andrewhaggstrom0/tsp05-sensors-motor-control/calibration/plots/dc_position_steps_compare.png

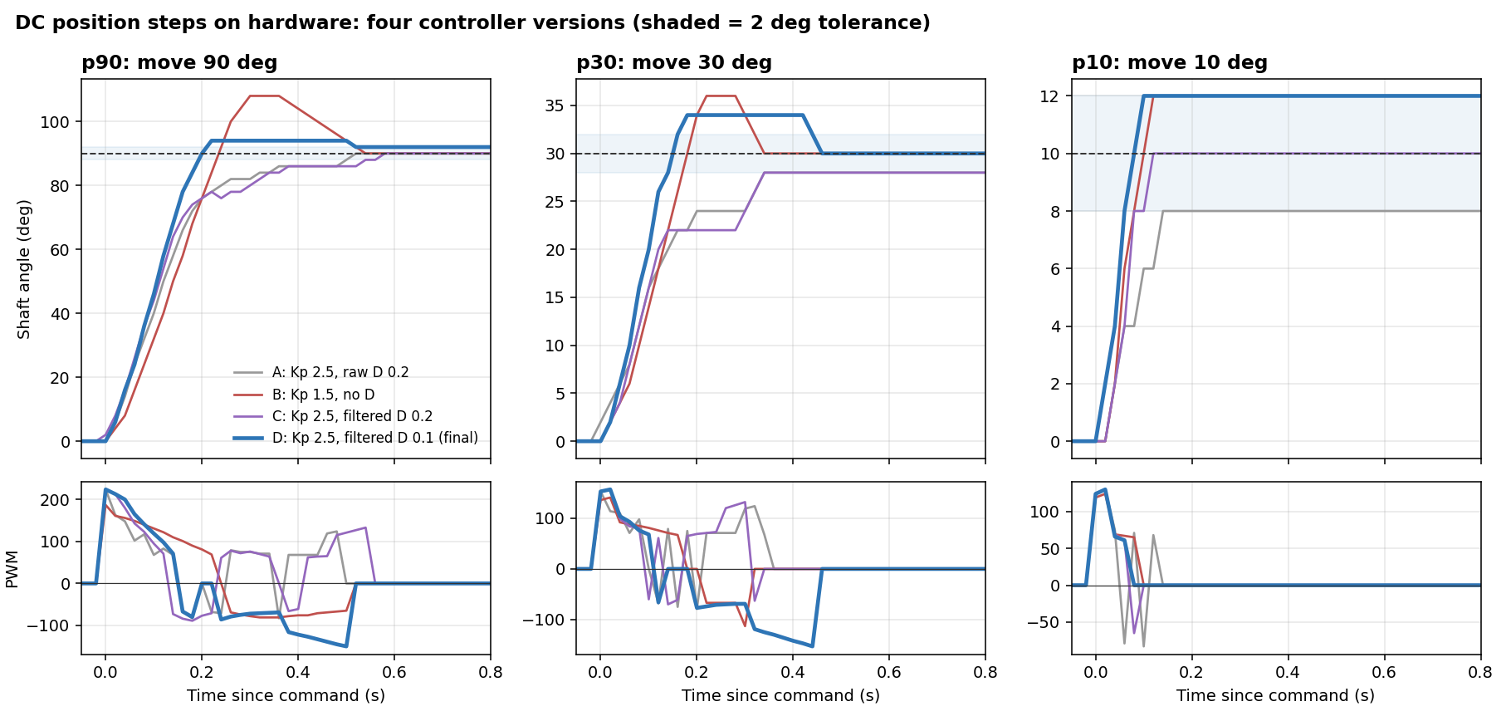
calibration/plots/dc_position_steps_compare.png
