andrewhaggstrom0/tsp05-sensors-motor-control/calibration/plots/dc_step_v60.png

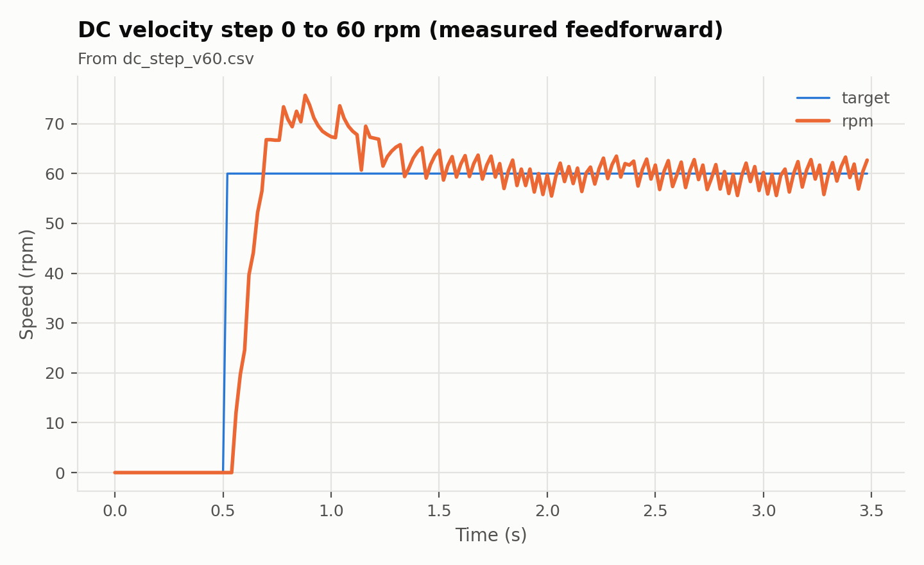
calibration/plots/dc_step_v60.png
