andrewhaggstrom0/tsp05-sensors-motor-control/calibration/plots/dc_step_v60_compare.png

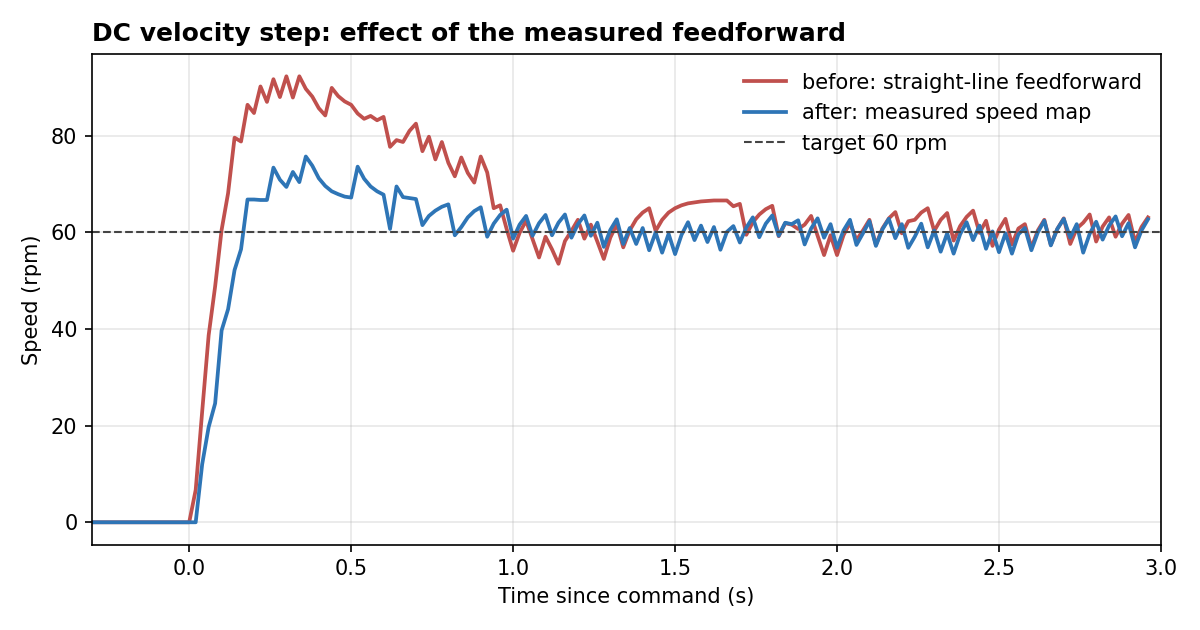
calibration/plots/dc_step_v60_compare.png
