andrewhaggstrom0/tsp05-sensors-motor-control/calibration/plots/dc_step_v60_linear_ff.png

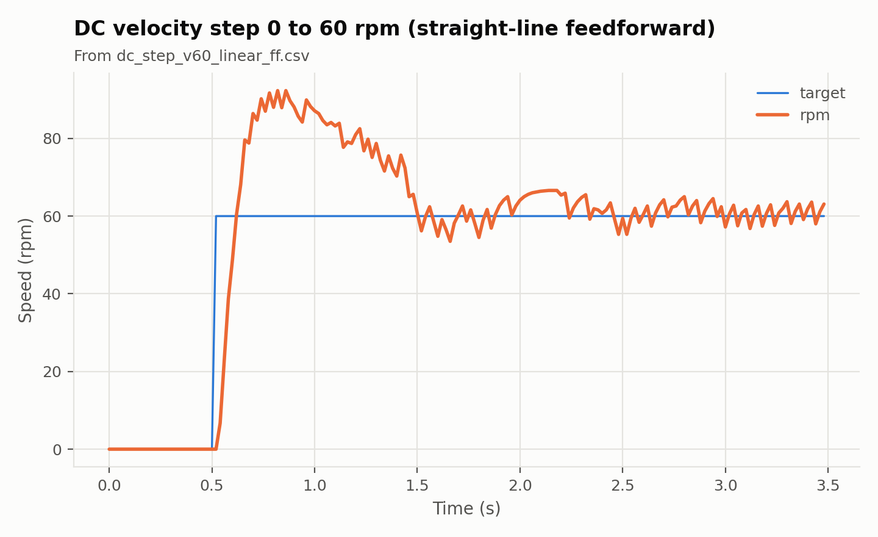
calibration/plots/dc_step_v60_linear_ff.png
