andrewhaggstrom0/tsp05-sensors-motor-control/calibration/data/dc_counts_per_rev.csv

direction | trial | turns | counts
forward | 1 | 10 | 1799
