andrewhaggstrom0/tsp05-sensors-motor-control/calibration/data/dc_speed_map.csv

direction | pwm | counts_per_s_mean | counts_per_s_std | n
forward | 255 | 422.0 | 2.4 | 5
forward | 230 | 379.0 | 2.0 | 5
forward | 205 | 360.0 | 2.9 | 6
forward | 180 | 341.0 | 2.0 | 5
forward | 155 | 312.5 | 2.5 | 6
forward | 130 | 280.0 | 2.9 | 6
forward | 110 | 237.5 | 2.5 | 6
forward | 95 | 194.2 | 1.9 | 6
forward | 85 | 161.0 | 2.0 | 5
forward | 75 | 123.0 | 2.4 | 5
forward | 68 | 94.0 | 2.0 | 5
forward | 63 | 71.7 | 2.4 | 6
reverse | -255 | -445.8 | 1.9 | 6
reverse | -230 | -385.0 | 0.0 | 6
reverse | -205 | -361.7 | 2.4 | 6
reverse | -180 | -339.2 | 1.9 | 6
reverse | -155 | -304.2 | 1.9 | 6
reverse | -130 | -256.7 | 3.7 | 6
reverse | -110 | -211.7 | 2.4 | 6
reverse | -95 | -167.5 | 2.5 | 6
reverse | -85 | -136.0 | 2.0 | 5
reverse | -75 | -99.0 | 2.0 | 5
reverse | -68 | -73.0 | 2.4 | 5
reverse | -63 | -55.8 | 1.9 | 6
