andrewhaggstrom0/tsp05-sensors-motor-control/calibration/data/flex.csv

trial | direction | ref_deg | adc_mean | adc_std | n
1 | bend | 0.0 | 470.20 | 0.53 | 50
1 | bend | 15.0 | 445.26 | 8.50 | 50
1 | bend | 30.0 | 399.72 | 9.19 | 50
1 | bend | 45.0 | 380.68 | 8.36 | 50
1 | bend | 60.0 | 371.14 | 10.34 | 50
1 | bend | 75.0 | 338.02 | 7.89 | 50
1 | bend | 90.0 | 306.84 | 9.40 | 50
