andrewhaggstrom0/tsp05-sensors-motor-control/calibration/data/flex_filter.csv

t_s | flex_adc
0.000 | 463
0.020 | 463
0.040 | 464
0.060 | 464
0.080 | 464
0.100 | 464
0.120 | 464
0.140 | 463
0.160 | 464
0.180 | 463
0.200 | 463
0.220 | 464
0.240 | 464
0.260 | 464
0.280 | 464
0.300 | 463
0.320 | 465
0.340 | 462
0.360 | 464
0.380 | 463
0.400 | 463
0.420 | 463
0.440 | 463
0.460 | 463
0.480 | 463
0.500 | 463
0.520 | 463
0.540 | 462
0.560 | 463
0.580 | 462
0.600 | 463
0.620 | 462
0.640 | 462
0.660 | 463
0.680 | 463
0.700 | 463
0.720 | 463
0.740 | 463
0.760 | 463
0.780 | 464
0.800 | 463
0.820 | 464
0.840 | 463
0.860 | 464
0.880 | 464
0.900 | 464
0.920 | 464
0.940 | 464
0.960 | 463
0.980 | 464
1.000 | 463
1.020 | 463
1.040 | 462
1.060 | 463
1.080 | 463
1.100 | 462
1.120 | 461
1.140 | 459
1.160 | 461
1.180 | 462
1.200 | 458
1.220 | 460
1.240 | 459
1.260 | 460
1.280 | 461
1.300 | 459
1.320 | 461
1.340 | 454
1.360 | 453
1.380 | 453
1.400 | 443
1.420 | 435
1.440 | 434
1.460 | 436
1.480 | 435
1.500 | 419
1.520 | 409
1.540 | 405
1.560 | 418
1.580 | 414
1.600 | 413
1.620 | 392
1.640 | 400
1.660 | 377
1.680 | 394
1.700 | 384
1.720 | 378
1.740 | 367
1.760 | 365
1.780 | 368
1.800 | 362
1.820 | 341
1.840 | 351
1.860 | 346
1.880 | 357
1.900 | 342
1.920 | 342
1.940 | 335
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
