andrewhaggstrom0/tsp05-sensors-motor-control/calibration/data/slot_rpm.csv

t_s | step_deg | slot_count | slot_rpm
0.000 | 0.000 | 0 | 0.00
0.050 | 6.080 | 0 | 0.00
0.100 | 14.180 | 0 | 0.00
0.150 | 22.050 | 1 | 0.00
0.201 | 29.700 | 1 | 0.00
0.251 | 37.580 | 1 | 0.00
0.301 | 45.230 | 1 | 0.00
0.351 | 52.880 | 1 | 0.00
0.402 | 60.300 | 1 | 0.00
0.452 | 67.950 | 1 | 0.00
0.502 | 75.380 | 1 | 0.00
0.552 | 83.250 | 1 | 0.00
0.602 | 90.900 | 1 | 0.00
0.652 | 98.550 | 1 | 0.00
0.702 | 106.200 | 1 | 0.00
0.752 | 113.850 | 1 | 0.00
0.802 | 121.500 | 1 | 0.00
0.852 | 129.150 | 1 | 0.00
0.903 | 137.020 | 1 | 0.00
0.953 | 144.900 | 1 | 0.00
1.003 | 152.550 | 1 | 0.00
1.053 | 160.200 | 1 | 0.00
1.103 | 167.850 | 1 | 0.00
1.153 | 175.500 | 1 | 0.00
1.203 | 182.930 | 1 | 0.00
1.253 | 190.580 | 1 | 0.00
1.303 | 198.680 | 1 | 0.00
1.353 | 206.330 | 1 | 0.00
1.403 | 214.200 | 1 | 0.00
1.453 | 221.850 | 1 | 0.00
1.503 | 229.500 | 1 | 0.00
1.554 | 237.380 | 1 | 0.00
1.603 | 245.030 | 1 | 0.00
1.653 | 252.680 | 1 | 0.00
1.703 | 260.330 | 1 | 0.00
1.754 | 268.200 | 1 | 0.00
1.803 | 275.630 | 1 | 0.00
1.853 | 283.280 | 1 | 0.00
1.903 | 290.920 | 1 | 0.00
1.954 | 298.800 | 1 | 0.00
2.003 | 306.450 | 1 | 0.00
2.054 | 314.330 | 1 | 0.00
2.104 | 322.200 | 1 | 0.00
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
