andrewhaggstrom0/tsp05-sensors-motor-control/firmware/tsp05/dc_motor.h

#pragma once

void  dcInit();
void  dcUpdate();                  // call every loop(); runs the controller every DC_PERIOD_MS

void  dcMoveRelative(float deg);   // position mode: move deg from current position
void  dcSetVelocity(float rpm);    // velocity mode: hold signed rpm
void  dcStop();
void  dcSetInterlock(bool active); // true: stop and ignore commands

float dcDeg();
float dcRpm();
int   dcPwm();                     // -255..255
bool  dcArrived();                 // position mode: within DC_POS_TOL_DEG of target
int   dcMode();                    // 0 idle, 1 velocity, 2 position (telemetry dc_mode)
float dcTarget();                  // position mode: target deg; velocity mode: target rpm; idle: 0
