andrewhaggstrom0/tsp05-sensors-motor-control/firmware/tests/test_sensors_analog.cpp

// Host-side tests for firmware/tsp05/sensors_analog.cpp
// Run: firmware/tests/run_tests.sh
#include <cstdio>
#include <cmath>
#include "Arduino.h"
#include "config.h"
#include "sensors_analog.h"

int fake_adc[24] = {0};
uint32_t fake_millis = 0;
long fake_analog_reads = 0;

static int g_fail = 0, g_pass = 0;
#define CHECK(cond, ...) do { if (cond) { g_pass++; } else { g_fail++; \
  printf("FAIL %s:%d  ", __FILE__, __LINE__); printf(__VA_ARGS__); printf("\n"); } } while (0)

using namespace analog_math;

// Independent reference (double precision) to check the firmware math
static double refThermC(double adc) {
  // Uses the config.h constants, so it stays valid after measured resistor
  // values or a datasheet B are put in config.h.
  double r = (double)THERM_FIXED_R_OHMS * adc / (1023.0 - adc);
  return 1.0 / (1.0 / (double)THERM_T0_K + std::log(r / (double)THERM_R0_OHMS) / (double)THERM_BETA)
         - 273.15;
}

static void test_thermistor_math() {
  // When R_t = R0 the temperature is exactly T0 (25 degC). That happens at
  // adc = 1023 * R0 / (R_fixed + R0), which is 511.5 only if R_fixed = R0.
  float adcAtT0 = 1023.0f * THERM_R0_OHMS / (THERM_FIXED_R_OHMS + THERM_R0_OHMS);
  float c = thermCFromOhms(thermOhmsFromAdc(adcAtT0));
  float t0c = THERM_T0_K - 273.15f;
  CHECK(std::fabs(c - t0c) < 0.01f, "R_t = R0 gave %.3f C, want %.2f", c, t0c);

  // Matches double-precision reference across the usable range
  for (int adc = 50; adc <= 970; adc += 20) {
    float got = thermCFromOhms(thermOhmsFromAdc((float)adc));
    double want = refThermC(adc);
    CHECK(std::fabs(got - want) < 0.05, "adc %d: got %.3f want %.3f", adc, got, want);
  }

  // Warmer -> lower thermistor R -> lower A1 counts: temperature must fall as adc rises
  float prev = 1e9f;
  for (int adc = THERM_ADC_SHORT + 1; adc < THERM_ADC_OPEN; adc++) {
    float t = thermCFromOhms(thermOhmsFromAdc((float)adc));
    CHECK(std::isfinite(t), "adc %d gave non-finite temp", adc);
    CHECK(t < prev, "not monotonic at adc %d", adc);
    prev = t;
  }

  // Round trip at real operating points (ice bath, body): degC -> ohms (Beta
  // law) -> counts (divider) -> back through the firmware. Uses config.h, so it
  // holds for measured resistor values too.
  const float pts[] = {0.0f, 37.0f, 55.0f};
  for (float tc : pts) {
    double rt = THERM_R0_OHMS * std::exp(THERM_BETA * (1.0 / (tc + 273.15) - 1.0 / THERM_T0_K));
    float adc = (float)(1023.0 * rt / (THERM_FIXED_R_OHMS + rt));
    float back = thermCFromOhms(thermOhmsFromAdc(adc));
    CHECK(std::fabs(back - tc) < 0.05f, "%.0f C -> %.1f counts -> %.3f C", tc, adc, back);
  }

  // Edge cases
  CHECK(thermOhmsFromAdc(0) < 0 && thermOhmsFromAdc(1023) < 0, "edge adc should be -1");
  CHECK(std::isnan(thermCFromOhms(-1.0f)), "negative ohms should give NaN");
  CHECK(thermAdcIsFault(1023) && thermAdcIsFault(0), "open/short must be faults");
  CHECK(!thermAdcIsFault(511), "midpoint must not be a fault");
}

static double refFlexOhms(double adc) {
  return (double)FLEX_FIXED_R_OHMS * (1023.0 - adc) / adc;
}

static void test_flex_math() {
  // Divider math against a double-precision reference
  for (int adc = 50; adc <= 970; adc += 20) {
    double want = refFlexOhms(adc);
    float got = flexOhmsFromAdc((float)adc);
    CHECK(std::fabs(got - want) / want < 1e-5, "adc %d: %.1f ohm want %.1f", adc, got, want);
  }
  CHECK(flexOhmsFromAdc(0) < 0 && flexOhmsFromAdc(1023) < 0, "edge adc should be -1");

  // Whatever table is loaded (placeholder or fitted): bending raises resistance,
  // which lowers the A0 reading, so the angle must never decrease as adc falls,
  // never be NaN, and stay inside the clamps.
  float prev = -1e9f;
  for (int adc = ADC_MAX - 1; adc >= 1; adc--) {
    float d = flexDegFromAdc((float)adc);
    CHECK(std::isfinite(d), "adc %d gave non-finite angle", adc);
    CHECK(d >= FLEX_DEG_MIN && d <= FLEX_DEG_MAX, "adc %d gave %.1f deg out of range", adc, d);
    CHECK(d >= prev, "angle not monotonic at adc %d", adc);
    prev = d;
  }
  CHECK(flexDegFromOhms(1e9f) == FLEX_DEG_MAX, "huge R should clamp to max");
  CHECK(flexDegFromOhms(0.0f) == FLEX_DEG_MIN, "zero R should clamp to min");

  // Faults: unplugged sensor pulls A0 to 0, a short pulls it to 1023
  CHECK(flexAdcIsFault(0) && flexAdcIsFault(1023), "open/short must be faults");
  CHECK(!flexAdcIsFault(506), "flat reading must not be a fault");
}

static void test_ema() {
  float y = 0.0f;
  for (int i = 0; i < 100; i++) y = ema(y, 10.0f, 0.2f);
  CHECK(std::fabs(y - 10.0f) < 1e-3f, "EMA should converge to step, got %.4f", y);
  CHECK(std::fabs(ema(0.0f, 10.0f, 0.2f) - 2.0f) < 1e-6f, "one EMA step should be 2.0");
}

static void test_module_update() {
  fake_millis = 1000;
  // Flat-ish (10k) and bent (20k) readings. Expected angles come from the
  // conversion function, so this test does not depend on which table is loaded.
  int adcFlat = (int)lround(1023.0 * FLEX_FIXED_R_OHMS / (FLEX_FIXED_R_OHMS + 10000.0));
  fake_adc[A0] = adcFlat;
  fake_adc[A1] = 512;    // ~25 C with nominal parts
  analogSensorsInit();
  CHECK(!thermistorFault(), "good reading should clear fault");
  CHECK(std::fabs(thermistorC() - (float)refThermC(512)) < 0.05f, "init temp %.2f, want %.2f",
        thermistorC(), refThermC(512));
  CHECK(!flexFault(), "flat flex reading should clear fault");
  float degFlat = flexDegFromAdc((float)adcFlat);
  CHECK(flexDeg() == degFlat && flexDegFiltered() == degFlat,
        "first reading should seed the filter: %.2f / %.2f, want %.2f",
        flexDeg(), flexDegFiltered(), degFlat);

  // Rate limiting: nothing happens before the period elapses
  int adcBent = (int)lround(1023.0 * FLEX_FIXED_R_OHMS / (FLEX_FIXED_R_OHMS + 20000.0));
  fake_adc[A0] = adcBent;
  long reads = fake_analog_reads;
  fake_millis += ANALOG_PERIOD_MS - 1;
  analogSensorsUpdate();
  CHECK(fake_analog_reads == reads, "update ran early (no ADC reads expected)");
  CHECK(flexRaw() == adcFlat, "raw changed before period elapsed");

  // After the period it samples, and the filter lags the raw value
  fake_millis += 1;
  analogSensorsUpdate();
  CHECK(flexRaw() == adcBent, "raw should update, got %d", flexRaw());
  float degBent = flexDegFromAdc((float)adcBent);
  CHECK(degBent > degFlat + 10.0f, "20k (%.1f deg) should read well above 10k (%.1f deg)",
        degBent, degFlat);
  CHECK(flexDeg() == degBent, "module should report %.2f deg, got %.2f", degBent, flexDeg());
  CHECK(flexDegFiltered() > degFlat && flexDegFiltered() < flexDeg(),
        "filtered (%.2f) should lag raw (%.2f)", flexDegFiltered(), flexDeg());

  // Unplugged flex sensor: fault set, angle holds its last good value
  float flexGood = flexDeg(), flexFiltGood = flexDegFiltered();
  fake_adc[A0] = 0;
  fake_millis += ANALOG_PERIOD_MS;
  analogSensorsUpdate();
  CHECK(flexFault(), "unplugged flex should fault");
  CHECK(flexDeg() == flexGood && flexDegFiltered() == flexFiltGood, "angle should hold during fault");
  fake_adc[A0] = adcBent;
  fake_millis += ANALOG_PERIOD_MS;
  analogSensorsUpdate();
  CHECK(!flexFault(), "flex should recover");

  // Unplugged thermistor: fault set, temperature holds last good value
  float lastGood = thermistorC();
  fake_adc[A1] = 1023;
  fake_millis += ANALOG_PERIOD_MS;
  analogSensorsUpdate();
  CHECK(thermistorFault(), "unplugged thermistor should fault");
  CHECK(thermistorC() == lastGood, "temp should hold during fault");
  CHECK(std::isfinite(thermistorC()), "temp must never be NaN");

  // Recovers when plugged back in
  fake_adc[A1] = 400;
  fake_millis += ANALOG_PERIOD_MS;
  analogSensorsUpdate();
  CHECK(!thermistorFault() && thermistorC() > 30.0f, "should recover, got %.2f", thermistorC());

  // millis() rollover does not stall updates
  fake_millis = 0xFFFFFFFFu - 5;
  analogSensorsUpdate();
  fake_adc[A0] = adcFlat;
  fake_millis = 0xFFFFFFFFu - 5 + ANALOG_PERIOD_MS;  // wraps past zero
  analogSensorsUpdate();
  CHECK(flexRaw() == adcFlat, "update should run across millis() rollover");
}

int main() {
  test_thermistor_math();
  test_flex_math();
  test_ema();
  test_module_update();
  printf("%d passed, %d failed\n", g_pass, g_fail);
  return g_fail ? 1 : 0;
}
