andrewhaggstrom0/tsp05-sensors-motor-control/(commit log)

2026-11-01 Initial repo structure: pin map, protocol spec, PR template, README skeleton
2026-11-07 Add analog sensor module: FSR force via conductance table, thermistor Beta conversion, EMA filter, fault detection
2026-11-07 Add host-side unit tests for analog module with Arduino shim
2026-11-07 Add Python reference model of analog sensors and firmware cross-check
2026-11-07 Add analog bring-up sketch and calibration logger with simulated sensor
2026-11-07 Document calibration CSV schemas and hardware-day procedure
2026-11-07 Add calibration plotter: transfer function, FSR fit and firmware table, filter plot, error tables, Foxglove CSV support
    [plot_calibration.py]
2026-11-07 Add M0 open-loop DC bring-up sketch and deadband CSV
    Serial-driven PWM (-255..255) on the L298 (D5 EN, D7/D8 IN1/IN2) to measure
    the start and stop deadband in each direction. Non-blocking line reader avoids
    Serial.parseInt(), whose leftover newline reads as a second 0 and stops the motor.
    [dc_deadband.csv]
2026-11-07 Add M1 encoder bring-up sketch and counts-per-rev CSV
    2x decoding on encoder A (INT0, CHANGE) with B read in the ISR for direction.
    The 32-bit count is copied with interrupts paused. Prints ms,pwm,counts,cps at
    5 Hz for the counts-per-rev and sign checks. Adds an empty
    calibration/data/dc_counts_per_rev.csv (direction, trial, turns, counts).
    [dc_counts_per_rev.csv]
2026-11-07 Add DC motor module: speed estimate, velocity PI, position PID, host tests
    dc_control is hardware-free: counts/deg/rpm conversions, deadband compensation,
    PID with clamped integral and no derivative kick, and a per-period controller
    step for IDLE, VELOCITY (feedforward + PI) and POSITION (PID, stop inside
    DC_POS_TOL_DEG). dc_motor wires it to the L298 and the encoder ISR and enforces
    the thermal interlock.
    Tests run the controller against a simulated motor with stick-slip friction
    and a deadband and top speed that differ from the config placeholders.
    A position Ki of 20 was needed: without it the motor stalls a few degrees
    short with a PWM below its starting deadband.
    [config.h, dc_control.cpp, dc_control.h, dc_motor.cpp, dc_motor.h, test_dc_control.cpp]
2026-11-07 Use measured divider resistors; make analog tests derive expectations from config.h
2026-11-07 Switch A0 sensor from FSR to flex sensor: report bend angle in degrees, rename API to flex*
    [analog.ino, analog_model.py, check_firmware_vs_model.py, config.h, dump_conversions.cpp, log_serial.py, plot_calibration.py, sensors_analog.cpp]
2026-11-07 Fix logger capturing stale samples over usbipd: read the port continuously in a background thread
    [log_serial.py]
2026-11-07 Add thermistor and flex calibration data, figures, error tables, and fitted flex table
    [flex.csv, flex_filter.csv, thermistor.csv]
2026-11-07 Document analog sensor wiring: schematic generated from config.h, pin map section
2026-11-08 Add DC closed-loop bring-up sketch, module sync script, step-response logger
    dc_pid.ino drives the real dc_motor module from serial commands (p<deg>,
    v<rpm>, x, i1/i0) and streams ms,mode,target,deg,rpm,pwm at 50 Hz.
    sync_dc_bringup.sh copies the module into the sketch folder (copies are
    git-ignored) so there is one source of truth in firmware/tsp05.
    log_dc_step.py sends one step command, records the stream, and writes
    calibration/data/dc_step_<cmd>.csv for plot_calibration.py --timeseries.
2026-11-08 Added servo range check code
2026-11-08 config: add Track 2 constants (servo, stepper, button, mappings, interlock)
2026-11-08 Button: 30 ms debounce, press-edge toggle
2026-11-08 Servo + non-blocking stepper
2026-11-08 Parser, modes, mappings, interlock, 20 Hz telemetry
2026-11-08 Add Docker ROS 2 dev environment and fake Arduino serial simulator
    docker/: ros:jazzy image (ROS_DISTRO=humble selectable) with
    foxglove_bridge and pyserial. The repo is mounted at /tsp05, the container
    runs as the host user, and port 8765 is published for the Foxglove app.
    docker/run.sh opens a shell or runs one command. Code stays plain ROS 2 /
    Python, so it also runs on native Ubuntu without Docker.
    tools/fake_arduino.py: a pty that speaks docs/protocol.md. It sends the
    19-field T line at 20 Hz and accepts M, S, D,P, D,V, D,X and P commands
    (motor commands ignored in SENSOR mode). Simulates the sensors (raw ADC via
    tools/analog_model.py), servo slew, a first-order DC motor with a positio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
2026-11-08 Add tsp05_bridge package with protocol parser, command formatting, and tests
    ros2_ws/src/tsp05_bridge (ament_python): tsp05_bridge/protocol.py is the
    laptop side of docs/protocol.md with no ROS dependency.
    - parse_telemetry(): 18 named fields after "T"; raises only ParseError for
    wrong field count, non-numeric or non-finite values, or a mode/interlock
    flag that is not 0/1. Accepts CRLF (Serial.println).
    - is_telemetry(): '#' comments and noise (e.g. a half line after a reset)
    are not telemetry.
    - cmd_*(): M, S, D,P, D,V, D,X, P strings with 1-decimal values; reject
    NaN/inf so a bad GUI value never reaches the Uno.
    38 pytest tests: field order is checked against docs/protocol.md itse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
    [protocol.py, test_protocol.py]
2026-11-08 Add tsp05_bridge ROS 2 node: telemetry topics, command topics, auto-reconnect
    bridge_node.py (ros2 run tsp05_bridge bridge):
    - Publishes every telemetry field on /tsp05/* (Float32; mode Int8,
    interlock Bool), names per the team guide with fsr/* -> flex/* after the
    A0 sensor change. Also /tsp05/uno_ms, /tsp05/bridge/connected (1 Hz) and
    /tsp05/log ('#' lines from the Uno, e.g. commands ignored in SENSOR mode).
    - Subscribes to /tsp05/cmd/{mode,servo_deg,dc_move_deg,dc_rpm,dc_stop,
    stepper_deg} and writes M, S, D,P, D,V, D,X, P. NaN/inf is rejected.
    - Parameters: port (device path or any pyserial URL, e.g. socket://),
    baud, reconnect_period, stats_period.
    - A background thread reads c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
    [bridge_node.py, test_bridge_integration.py]
2026-11-08 Add one-command launch file and Foxglove layout with plots and indicators
    launch/tsp05.launch.py: bridge + foxglove_bridge (0.0.0.0:8765, so the
    Foxglove app on the host reaches it through Docker's port mapping).
    ros2 launch tsp05_bridge tsp05.launch.py # real Uno
    ros2 launch tsp05_bridge tsp05.launch.py fake:=true # + fake Arduino
    Args: port, baud, fake, fake_link, foxglove, foxglove_port. The fake
    Arduino script is found by walking up from the launch file (works from the
    colcon install space) or via $TSP05_REPO. topic_whitelist limits the
    websocket to /tsp05/* and /rosout. client_topic_whitelist is not used:
    foxglove_bridge 3.6 accepted a client publisher on /tsp05/s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
2026-11-08 Add Foxglove command panel extension: mode, servo, DC, stepper, STOP
    foxglove/tsp05-control-panel: a Foxglove extension panel ("TSP05 Controls")
    so every command is sent by clicking (Track 5 step R5).
    - Mode toggle (GUI/SENSOR) showing the current mode from /tsp05/mode.
    - Servo slider + 0/90/180 presets; DC move N deg (+-90 presets) and hold
    RPM; stepper -/+ N deg; live servo, DC deg/RPM, stepper actual/target.
    - STOP works in both modes: in SENSOR mode the firmware ignores motor
    commands, so it sends M,0 then D,X.
    - Motor buttons are disabled while the Uno is disconnected (no telemetry for
    2 s or /tsp05/bridge/connected false) or in SENSOR mode; interlock banner.
    - Advertises /tsp05/c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
2026-11-08 Document Track 5 in README: running (Docker and native), contribution, challenges, figure
    README.md (Track 5 parts only):
    - Software: bridge, layout, control panel, fake Arduino, docker/; embeds the
    architecture figure.
    - Running: Docker (fake Arduino, tests, Humble, real Uno on Linux via
    TSP05_SERIAL_DEVICE, socat + socket:// on macOS), native Ubuntu (apt,
    dialout, colcon build/launch/test), Foxglove connect, layout import, panel
    install, launch arguments.
    - Individual Contributions (Raoul Bouri) with measured numbers: 19.99 Hz on
    every topic; command -> telemetry round trip median 31 ms, p95 52 ms (n=200,
    random timing); 48 + 8 tests.
    - Challenges: fake Arduino stalling on a fu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
    [draw_bridge_diagram.py, test_bridge_integration.py]
2026-11-08 Add Track 3 digital sensors interface: TOF + slot sensor API stubs
2026-11-08 Stepper verified: 1600 steps/rev; coil pairs red-green / blue-black (35.9 ohm); TP1 1.70 V
2026-11-08 Tested Servo, Stepper and Button
2026-11-08 Add TOF + slot sensor bring-up sketch: short-range TOF at 33 ms budget, slot ISR with 1 ms glitch filter
    [digital.ino]
2026-11-08 Add Track 3 constants to config.h: TOF timing, filter, slot tabs, RPM window and timeout
2026-11-08 Implement digital sensors: non-blocking TOF with median-of-5 + EMA filter, slot ISR with period-based RPM
2026-11-08 Reset TOF-present flag in init so a missing sensor is always reported
    [sensors_digital.cpp]
2026-11-08 Add host tests for digital sensors: TOF median+EMA, invalid/stale faults, slot glitch filter, period RPM with uneven tabs
    [test_sensors_digital.cpp]
2026-11-08 Add TOF calibration tool: error logging, raw-vs-filtered recording, error table and plots, --sim rehearsal
    [tof_calibration.py]
2026-11-08 README: add Track 3 contribution (TOF, slot sensor, RPM, tools, tests) and first challenge
2026-11-09 Handle stiction: separate breakaway and running deadbands, ramp while stuck
    Bench test on the SPG30: from rest it needs PWM 110-140 forward and 90-120
    reverse to start, and the amount depends on where the shaft came to rest
    (repeat starts needed 130, then 140 after 130 failed, then 115). Once turning
    it keeps going down to 56-59. With a single deadband the position loop either
    stalled short or lurched past and hunted (19 restarts on a 15 deg move in
    simulation).
    ctrlStep uses DC_DEADBAND_RUN_PWM once the motor is moving. While commanded
    but stopped, the breakaway deadband ramps from DC_DEADBAND_START_PWM (110) at
    DC_BREAKAWAY_RAMP (300 PWM/s) up to DC_BREAKAWAY_MAX_PWM (200) and resets once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
    [config.h, dc_control.cpp, dc_control.h, test_dc_control.cpp]
2026-11-09 Record DC deadband measurements; set running deadband to 60
    Three trials each way at 12 V on the L298N: breakaway from rest 115-140
    forward, 110-120 reverse; a turning motor stops at 56-59 in both directions.
    DC_DEADBAND_RUN_PWM is set just above the highest stop (59) so slow commands
    don't stall mid-move. Test motor updated to the measured reverse breakaway;
    all 357 simulated moves still settle (worst 3.5 deg, slowest 1.0 s).
    [dc_deadband.csv]
2026-11-09 Set TELEMETRY_PERIOD_MS to 50 ms (20 Hz); main had 1000 (1 Hz), which the comment, bridge and protocol do not match
2026-11-10 TOF error, 50-500 mm x 20 samples: mean -15.9 mm, RMS 16.7 mm, std <= 3.1 mm; constant offset (slope 0.993), 5.1 mm RMS after offset correction
    [tof_error.csv]
2026-11-10 tof_calibration: drop stale samples sent before the Uno reset and leading 0 mm samples (broke the filter plot's time axis)
    [tof_calibration.py]
2026-11-10 TOF raw vs filtered (firmware output): noise 2.10 -> 0.31 mm, 85% reduction; median-5 + EMA 0.3, lag ~80 ms + 112 ms time constant
    [tof_filter.csv]
2026-11-10 Bring-up sketch: correct expected VL53L1X ID comment to 0xEACC
    [digital.ino]
2026-11-10 README: Track 3 hardware results (TOF error + filter tables and plots, slot 50/50) and three hardware challenges
2026-11-10 Slot disc with 1 tab: SLOT_TABS 4 -> 1, SLOT_TIMEOUT_MS 2000 -> 5000 (one pass per rev at ~30 rpm); uneven-tab test handles any tab count
2026-11-10 Add slot RPM check: sends a stepper move, logs telemetry, compares slot_rpm with the speed from step_deg
2026-11-10 Slot RPM vs stepper, 10 rev: reference 26.28 rpm, slot_rpm 26.1-26.5 (within 1%), 10/10 events; stepper ran 12% below nominal 30 rpm
    [slot_rpm.csv]
2026-11-10 README: Track 3 RPM result vs stepper (within 1%), 1-tab disc, stepper-speed challenge
2026-11-10 Measure DC no-load speed; set DC_MAX_RPM to 140
    M1 bring-up at PWM 255 on 12 V through the L298N held 420 counts/s steadily
    for 5 s with no load: 420 / 180 counts per rev x 60 = 140 rpm. Positive PWM
    makes the count increase, so no wire swap is needed. Counts per rev stays at
    180 until a clean stopped-shaft measurement; the first two runs were read
    while the shaft was still turning and gave 160.6 and 179.
    [config.h]
2026-11-10 Confirm 180 encoder counts per output rev with a closed-loop move
    Counting turns by eye was unreliable: hand-counted runs gave 160.6, 179.0 and
    189.4 counts/rev, each within 1% of 180 if one turn was miscounted, and some
    were read while the shaft was still coasting. Instead dc_pid moved p3600
    (1800 counts at 180/rev): it settled at 3598 deg (1799 counts) with the tape
    mark just past the reference, under 0.3% error; p-3600 returned to the mark.
    Matches 3 Hall pulses x 2 edges x 30:1. Both moves stopped inside the 2 deg
    tolerance with PWM 0, no hunting: first closed-loop position test on hardware.
    [dc_counts_per_rev.csv]
2026-11-10 Add automated DC speed-vs-PWM sweep logger; make loggers reset the Uno
    tools/log_dc_speed_map.py drives firmware/bringup/dc_m1_encoder over serial:
    steps PWM down from 255 to 63 in each direction so the motor never stops (no
    breakaway needed), waits --settle s at each step, averages counts_per_s over
    --average s, and writes calibration/data/dc_speed_map.csv. Always sends 0 on
    exit, including Ctrl-C. Replaces typing values by hand, which mis-counted
    turns in M1.
    Both DC loggers waited for the sketch banner, which only prints after a
    reset. When the Uno did not auto-reset on port open, the banner had already
    gone by and the logger gave up although the sketch was running. open_port now
    pulses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
    [log_dc_speed_map.py, log_dc_step.py]
2026-11-10 Record DC steady speed vs PWM in both directions
    tools/log_dc_speed_map.py with the M1 sketch, 12 V on the L298N, no load,
    PWM stepped down from 255 so the motor never stopped. Std at every point is
    about 2 counts/s. The curve is strongly concave (205 to 230 adds only 6 rpm)
    and asymmetric: at PWM 95 reverse is 9 rpm slower than forward.
    [dc_speed_map.csv]
2026-11-10 Use the measured speed map for feedforward; calibrate simulator to hardware
    Velocity: the straight-line feedforward assumed PWM 143 for 60 rpm; the motor
    needs about 93, so a 0-60 rpm step peaked at 92 rpm (+54%). Feedforward now
    interpolates the measured counts/s-vs-PWM table per direction, and only the
    breakaway minimum is applied while stopped. On hardware the same step peaks at
    75 rpm (+25%) and is within 10% after 0.7 s instead of 1.7 s.
    Simulator: the test motor now uses the measured speed map, and its drive and
    coast time constants (0.03 s, 0.02 s) were fitted to the hardware p90/p30/p10
    steps (about 1.2 deg RMS). The old 0.08 s coast made it far too pessimistic.
    Position: the D ter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
2026-11-10 Add hardware step responses: velocity before/after feedforward, position with raw D
    dc_step_v60_linear_ff: straight-line feedforward, peak 92 rpm. dc_step_v60:
    measured speed-map feedforward, peak 75 rpm, settles in 0.7 s; repeated twice
    with the same result. dc_step_p{90,30,10}_rawD: all reach target within the
    2 deg tolerance in 0.2-0.5 s with no overshoot, but the raw-difference D term
    flips PWM sign 2-5 times near the target. Plots in calibration/plots.
    [dc_step_p10_rawD.csv, dc_step_p30_rawD.csv, dc_step_p90_rawD.csv, dc_step_v60.csv, dc_step_v60_linear_ff.csv]
2026-11-10 Tune position D term on hardware: Kp 2.5, filtered Kd 0.1
    Four controller versions run on the SPG30 for p90, p30 and p10:
    raw D 0.2: no overshoot, PWM flips sign 4-5 times per move (chatter)
    no D (Kp 1.5): no flips, but coasts 18 deg past on p90, 6 deg on p30
    filtered D 0.2: no overshoot, brakes so hard it stalls 12 deg short on p90
    and restarts several times
    filtered D 0.1: at most 1 sign flip and 4 deg overshoot; every move ends
    within the 2 deg tolerance in about 0.5 s
    The simulator could not reproduce the no-D coast, so this was chosen from
    the hardware runs rather than the simulated sweep.
    [config.h]
2026-11-10 Add hardware position steps for the D-term comparison
    dc_step_p{90,30,10}_{noD,filtD,filtD01}.csv with the matching _rawD runs,
    and calibration/plots/dc_position_steps_compare.png showing angle and PWM
    for all four versions with the 2 deg tolerance band.
    [dc_step_p10_filtD.csv, dc_step_p10_filtD01.csv, dc_step_p10_noD.csv, dc_step_p30_filtD.csv, dc_step_p30_filtD01.csv, dc_step_p30_noD.csv, dc_step_p90_filtD.csv, dc_step_p90_filtD01.csv]
2026-11-10 Add two-zone TOF swipe detector with host tests
    The VL53L1X is single-zone, but its 16x16 SPAD array can be limited to a
    region of interest. Alternating the left and right 8x16 halves (optical
    centres 167 and 231) gives two distances; the order in which they first see
    a hand is the swipe direction.
    tof_gesture::update takes one zone reading at a time. A pass ends when both
    zones have been clear for GESTURE_CLEAR_MS (so a fast swipe with a gap
    between zones still counts); it is a swipe only if both zones saw the hand
    at least GESTURE_MIN_GAP_MS apart. 60 ms is more than one 40 ms interleave
    step: with 40 ms a hand pushed straight in was reported as a swipe, because
    one zone is always sampled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
2026-11-10 Add TOF swipe bring-up sketch: servo sweeps in the swipe direction
    firmware/bringup/tof_swipe alternates the ROI between the two zones after
    every range, feeds the readings to tof_gesture, and sweeps the servo at
    GESTURE_SERVO_DEG_S toward one end after a right-to-left swipe and toward
    the other after left-to-right, stopping at the limits. Uses Track 3's TOF
    timing and Track 2's measured servo limits from config.h. Prints
    ms,zone,mm,status,servo_deg per reading for logging.
    tools/sync_tof_swipe.sh copies config.h and tof_gesture.* into the sketch.
2026-11-10 Fix TOF swipe zones: 8x10 ROI, 700 mm range
    Two bench captures showed both zones seeing the hand on the same reading.
    First cause, geometry: at 10-15 cm the 27 deg cone is only 5-7 cm wide, so a
    hand covers both halves at once; swipes need 30-50 cm, so GESTURE_NEAR_MM
    goes from 300 to 700 (an empty view reads as an invalid range, not as near).
    Second cause, the SparkFun library: setROI silently replaces the optical
    centre with 199 when width or height is over 10, so 8x16 zones centred on
    167 and 231 were both the same centred zone. 8x10 keeps the centres and
    still splits the view into left and right halves.
    [config.h]
2026-11-10 Detect swipes from entry and exit order; add bench recording
    With 8x10 zones the bench capture had 16 hand passes but the 60 ms entry gap
    caught only 7: in the rest one zone led by a single 40 ms step. The step is
    too small on its own (a straight push also gives one), but in all 16 passes
    the zone that saw the hand first also lost it first, and in the right
    direction.
    A pass is now a swipe when entry lead and exit lead have the same sign and
    add up to GESTURE_MIN_LEAD_MS (80 ms). Known limit: a clean straight push
    whose entry and exit orders happen to agree is still reported.
    calibration/data/tof_swipe_8x10.csv (ms,zone,mm,status) is the capture; a
    replay test runs it through tof_gesture a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
    [tof_swipe_8x10.csv]
2026-11-11 TOF: alternate left/right zones and report swipes from sensors_digital
    The sensor module now points every other range at the left or right 8x10
    half of the VL53L1X view and feeds each reading to tof_gesture.
    tofTakeSwipe() returns +1 (left to right), -1 (right to left) or 0, once
    per swipe. Init always starts on the left zone.
    The distance path is unchanged: every valid reading still goes through the
    median + EMA filter, and for one target both halves measure about the same
    distance, so tofRawMm/tofFiltMm and telemetry behave as before. All 37
    existing Track 3 tests pass; 4 new ones check a swipe each way, single
    reporting, and that the distance stays valid while zones alternate. The test
    s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
2026-11-11 SENSOR mode: TOF swipes sweep the servo instead of distance -> angle
    A right-to-left swipe sweeps the servo toward MAP_SERVO_MAX_DEG and
    left-to-right toward MAP_SERVO_MIN_DEG at GESTURE_SERVO_DEG_S, until the
    end of travel or the next swipe. GUI mode discards swipes, and switching
    mode stops the sweep. MAP_TOF_MIN_MM/MAX_MM are removed (nothing else used
    them).
    Checked by running the whole firmware on the host with a scripted two-zone
    TOF: no motion in GUI mode; in SENSOR mode a right-to-left swipe sweeps
    90 -> 133 deg, a left-to-right swipe reverses it, and it stops at 0 deg.
    [config.h, tsp05.ino]
2026-11-11 Sync fake Arduino with firmware on main: constants from config.h, real semantics
    tools/fake_arduino.py now reads every constant from firmware/tsp05/config.h
    (and the DC speed map from dc_control.cpp) and fails loudly if one is
    renamed, so it cannot drift from the firmware again. Behaviour mirrors main:
    - slot: SLOT_TABS = 1, rpm from the time across one revolution at 10 Hz with
    the slowing-down bound, 0 after SLOT_TIMEOUT_MS (5 s) (Track 3, PR #8)
    - SENSOR mode: TOF swipes sweep the servo at GESTURE_SERVO_DEG_S to the end
    of travel; flex 10-90 deg -> 0-60 rpm, re-sent only on 0.5 rpm changes;
    slot event -> 15 deg jog (PR #10, #7)
    - TOF raw/filtered update only on valid ranges: frozen w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
    [fake_arduino.py, test_bridge_integration.py, test_fake_arduino.py]
2026-11-11 Add tools/uno_relay.sh for the real Uno on macOS; fix the README relay steps
    Docker Desktop on macOS cannot pass USB devices into a container, so the
    bridge reaches the Uno through socat on the Mac. tools/uno_relay.sh:
    - finds the Uno (/dev/cu.usbmodem*, usbserial*, wchusbserial*) or takes a port
    - refuses to start if another program holds the port or the TCP port is busy
    - listens on 127.0.0.1:7777 only (TSP05_RELAY_PORT to change)
    - fork, so a bridge restart reconnects (reopening the port resets the Uno)
    README fixes found on hardware:
    - the documented socat command failed: socat 1.8 on macOS rejects b115200;
    ispeed=115200,ospeed=115200 works
    - port 7000 is also used by macOS's AirPlay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
2026-11-11 protocol.md: append dc_mode, dc_target, dc_arrived, tof_fault to the T line
    Four fields at the end of the telemetry line; existing positions unchanged.
    dc_mode (0 idle, 1 velocity, 2 position) says how to read dc_target (deg in
    position mode, rpm in velocity mode, 0 when idle). dc_arrived mirrors the
    controller's arrival band (DC_POS_TOL_DEG). tof_fault mirrors tofFault():
    missing sensor, no valid range yet, or none for TOF_STALE_MS. Receivers must
    accept both the 19-field line (older firmware) and the 23-field line.
2026-11-11 Firmware: send dc_mode, dc_target, dc_arrived, tof_fault at the end of the T line
    dc_motor: dcMode() returns the controller mode (0 idle, 1 velocity,
    2 position; a static_assert ties it to the values in docs/protocol.md) and
    dcTarget() the controller's target: degrees in position mode (from
    targetCounts, same frame as dcDeg()), rpm in velocity mode, 0 when idle.
    Both only read Ctrl state; no blocking, no String.
    tsp05.ino buildTelemetry() appends dcMode(), dcTarget() (1 decimal),
    dcArrived() and tofFault() after interlock. Worst-case line with every
    field at its widest is 145 chars including '\n', within g_tx[160]; the
    comment now states the bound and why overflow would merge two lines.
2026-11-11 Fake Arduino: send dc_mode, dc_target, dc_arrived, tof_fault; --legacy-telemetry for the old line
    Mirrors the new firmware getters: dc_mode_code() = dcMode() (0 idle,
    1 velocity, 2 position), dc_target() = dcTarget() (deg in position mode,
    rpm in velocity mode, 0 idle), dc_arrived_flag() = dcArrived() (position
    mode and inside DC_POS_TOL_DEG), tof_fault() = tofFault() (no valid range
    yet, or none for TOF_STALE_MS, read from config.h). dc_stop() clears the
    velocity target like ctrlStop(). --legacy-telemetry (FakeUno(legacy=True))
    sends the older 19-field line, for testing the bridge against old firmware.
    Fix (also present on main): slot rpm divided by zero when an edge and an
    rpm update fell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
    [fake_arduino.py, test_protocol.py]
2026-11-11 Tests for the appended telemetry fields: fake, bridge topics, legacy firmware
    test_fake_arduino.py: line lengths (23 new, 19 legacy); dc_mode/dc_target/
    dc_arrived through D,P (target = start + 90 in the dc_deg frame, arrived
    inside DC_POS_TOL_DEG), D,V (clamped to DC_MAX_RPM), mode switch (setMode
    stops: 0, then the SENSOR flex mapping: 1) and the interlock (0); tof_fault
    1 with no range since boot, 0 while ranging, 1 TOF_STALE_MS after the last
    valid range.
    test_bridge_integration.py: with 23-field telemetry the bridge advertises
    /tsp05/dc/mode, dc/target, dc/arrived, tof/fault, and they follow D,P 90 /
    D,V -45 / D,X; tof/fault goes 1 -> 0 -> 1 with the fake's hand pass. With
    --legacy-tel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
    [test_bridge_integration.py, test_fake_arduino.py]
2026-11-11 Document the telemetry feedback-fields prototype: change, evidence, issues, open questions
    docs/proposal_telemetry_feedback_fields.md records what this branch changes per
    file, the evidence (Uno build 68% flash / 60% RAM, +240 B / +4 B vs main;
    worst-case line 145 of 159 chars; 81/81 tests on Jazzy and Humble; firmware
    host tests pass), the issues found (dc_arrived flickers during real overshoot;
    a cut 23-field line can parse as a valid 19-field line; fake slot-rpm divide by
    zero also on main; stale memory baseline; not tested on hardware because the
    Mac cannot upload through its USB hub), what is left, and a draft message to
    Tracks 1-3. Parked: nothing here merges without the firmware owner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
2026-11-11 Fake Arduino: fix slot-rpm divide by zero; add tof_fault() ground truth
    _slot_rpm() divided by zero when a slot edge and an rpm update fell on the
    same instant (span 0). rpm_from_span() now returns 0 for an empty span, like
    the firmware's digital_math::rpmFromSpan(). Not reachable at the fake's 10 ms
    step, but tests stepping 50 ms hit it.
    tof_fault() mirrors the firmware's tofFault() (no valid range yet, or none
    for TOF_STALE_MS from config.h). It is not sent in telemetry; tests compare
    the bridge's inferred TOF fault against it.
    [fake_arduino.py]
2026-11-11 Bridge: feedback topics for DC target/arrival, command status, TOF fault and rate
    The firmware does not send the DC controller's target, its arrival, a TOF
    fault, or whether a command was obeyed (motor commands are ignored silently
    in SENSOR mode and during the interlock). tsp05_bridge/feedback.py works
    them out from the commands the bridge sends and the 19-field telemetry,
    following the firmware's own logic:
    - dc/mode (0 idle, 1 velocity, 2 position) and dc/target: D,P target = dc_deg
    when sent + the move in whole encoder counts; D,V clamped to DC_MAX_RPM;
    idle on D,X, a GUI/SENSOR change (setMode) and the interlock; SENSOR mode
    follows runSensorMappings() (flex dead zone, 0.5 rpm re-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
    [bridge_node.py, feedback.py, test_bridge_integration.py, test_feedback.py, test_foxglove_layout.py, topics.py]
2026-11-11 Bridge: dc/target_deg and dc/target_rpm for plots (NaN outside their mode)
    dc/target changes unit with dc/mode (deg in position mode, rpm in velocity
    mode), so a plot of it would draw rpm on a degree axis. The same target is
    now also published split by unit, NaN (a gap in the plot) when the DC
    controller is not in that mode. Integration test checks both; README lists
    them. docker/test.sh 99/99 on Jazzy and Humble.
2026-11-11 Control panel 0.2.0: DC arrived state, command status, link rate, TOF chip, presets, mapping card
    Uses the bridge feedback topics (dc/mode, dc/target, dc/settled, tof/fault,
    cmd/status, bridge/rate_hz, bridge/line_age_ms):
    - DC line: "moving to X (now Y)", "arrived at Y (target X)" once
    dc/settled, "not arrived after 3 s" as a warning, "holding R rpm",
    "stopped"
    - command feedback: each bridge status (applied in N ms / ignored (SENSOR
    mode) / ignored (interlock) / no effect) in green / amber / red, newest
    first, last 4
    - link line "Uno connected · 20.0 Hz" (amber below 15 Hz), "No telemetry
    for N s" after 1 s without lines, "No telemetry" at the 2 s stale limit;
    amber "TOF: no t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
2026-11-11 Foxglove layout: DC target lines, interlock threshold, TOF indicator, panel included
    - DC position plot: actual vs dc/target_deg (and PWM); DC velocity plot:
    measured vs dc/target_rpm, which also covers the SENSOR-mode flex mapping
    (was cmd/dc_rpm, GUI commands only)
    - new temperature plot with interlock/threshold_c as a line (the gauge
    goes; the plot shows how close the reading is to 30 C)
    - indicators in one row: Uno connected (now readable, background style),
    GUI/SENSOR mode, interlock, TOF ranging / no target
    - the TSP05 Controls panel is part of the layout: Foxglove names extension
    panels "<extension>.<panel>!<id>", read from a layout saved in Foxglove
    ("tsp05-control-panel.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
    [test_foxglove_layout.py]
2026-11-11 Proposal notes: hardware results on the Uno (DC fields, bridge + Foxglove, TOF)
    Prototype firmware on the Uno: 23-field lines at 20 Hz; D,P,90 gives
    dc_mode 2, dc_target 90.0, dc_arrived at 0.26 s (94 deg overshoot, then
    1 -> 0 -> 1, settles at 90.0); D,X back to idle. Through the bridge and
    Foxglove: 0 malformed, dc/settled after 0.75 s, every GUI command applied in
    14-90 ms. tof_fault 1 while the TOF gave no ranges, 0 once it did. Still to
    check: tof_fault timing after a hand leaves, the interlock, the flex sensor.
2026-11-11 Feedback: a command sent right after M,x is judged in the new mode
    The panel's STOP in SENSOR mode sends M,0 then D,X. The Uno handles them in
    order, so D,X is obeyed, but the bridge judged it against the last telemetry
    line (still SENSOR) and reported 'D,X: ignored (SENSOR mode)'. Seen in the
    bridge log on the Uno. The mode just sent now counts until telemetry shows it
    (or the command timeout passes). Test covers M,0 + D,X, M,1 + S, and expiry.
2026-11-11 Interlock threshold 29 C (was 30 C), bridge default to match
    Chosen on the bench: 30 C was hard to reach with the bead in a cool room;
    29 C trips reliably when warmed and stays off at room temperature. Tested on
    the Uno: interlock on above 29 C, DC command refused ('D,V,30.0: ignored
    (interlock)'), clears when cooled. The bridge's interlock_temp_c default
    (the limit line on the temperature plot) follows config.h; the test that
    checks they match passes. docker/test.sh 114/114 (Jazzy).
2026-11-12 README Track 3: TOF results predate the 8x10 swipe zones (PR #10); servo-range and memory figures updated
